Rivercraft911/rava-heart/mechanical/led_power_autoroute_report.csv

led_reference | cap_reference | rotation_deg | status | led_5v_via_x_mm | led_5v_via_y_mm | led_gnd_via_x_mm | led_gnd_via_y_mm | cap_5v_via_x_mm | cap_5v_via_y_mm | cap_gnd_via_x_mm | cap_gnd_via_y_mm | inserted_segments | inserted_vias
D2 | C11 | 0 | partial_manual:cap_5v+cap_gnd+led_5v | 132.3000 | 104.6100 | 133.7000 | 106.3900 | 131.8500 | 103.5000 | 134.1500 | 103.5000 | 1 | 1
D3 | C12 | 0 | partial_manual:cap_5v+cap_gnd | 137.9000 | 104.6100 | 139.3000 | 106.3900 | 137.4500 | 103.5000 | 139.7500 | 103.5000 | 2 | 2
D4 | C13 | 0 | partial_manual:cap_gnd+led_5v+led_gnd | 143.5000 | 104.6100 | 144.9000 | 106.3900 | 143.0500 | 103.5000 | 145.3500 | 103.5000 | 1 | 1
D5 | C14 | 180 | partial_manual:led_gnd | 144.9000 | 111.5900 | 143.5000 | 109.8100 | 145.3500 | 112.7000 | 143.0500 | 112.7000 | 3 | 3
D6 | C15 | 180 | skipped_custom_geometry |  |  |  |  |  |  |  |  | 0 | 0
D7 | C16 | 180 | partial_manual:cap_5v+led_5v+led_gnd | 133.7000 | 111.5900 | 132.3000 | 109.8100 | 134.1500 | 112.7000 | 131.8500 | 112.7000 | 1 | 1
D8 | C17 | 180 | partial_manual:cap_gnd+led_gnd | 128.1000 | 111.5900 | 126.7000 | 109.8100 | 128.5500 | 112.7000 | 126.2500 | 112.7000 | 2 | 2
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
