Rivercraft911/rava-heart/mechanical/heart_matrix_94mm_placement.csv

chain | chain_step | led_reference | cap_reference | x_mm | y_mm | rotation_deg | cap_x_mm | cap_y_mm | cap_rotation_deg | din_net | dout_net
1 | 1 | D13 | C22 | 138.6000 | 121.1000 | 180 | 138.6000 | 123.1000 | 180 | /LED_ARRAY/DIN | Net-(D12-DIN)
1 | 2 | D12 | C21 | 144.2000 | 121.1000 | 180 | 144.2000 | 123.1000 | 180 | Net-(D12-DIN) | Net-(D11-DIN)
1 | 3 | D11 | C20 | 144.2000 | 115.9000 | 0 | 144.2000 | 113.9000 | 0 | Net-(D11-DIN) | Net-(D10-DIN)
1 | 4 | D10 | C19 | 138.6000 | 115.9000 | 0 | 138.6000 | 113.9000 | 0 | Net-(D10-DIN) | Net-(D10-DOUT)
1 | 5 | D9 | C18 | 133.0000 | 115.9000 | 0 | 133.0000 | 113.9000 | 0 | Net-(D10-DOUT) | Net-(D8-DIN)
1 | 6 | D8 | C17 | 127.4000 | 110.7000 | 180 | 127.4000 | 112.7000 | 180 | Net-(D8-DIN) | Net-(D7-DIN)
1 | 7 | D7 | C16 | 133.0000 | 110.7000 | 180 | 133.0000 | 112.7000 | 180 | Net-(D7-DIN) | Net-(D6-DIN)
1 | 8 | D6 | C15 | 138.6000 | 110.7000 | 180 | 138.6000 | 112.7000 | 180 | Net-(D6-DIN) | Net-(D5-DIN)
1 | 9 | D5 | C14 | 144.2000 | 110.7000 | 180 | 144.2000 | 112.7000 | 180 | Net-(D5-DIN) | Net-(D4-DIN)
1 | 10 | D4 | C13 | 144.2000 | 105.5000 | 0 | 144.2000 | 103.5000 | 0 | Net-(D4-DIN) | Net-(D3-DIN)
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
