Rivercraft911/rava-heart/silkscreen_art/IMG_2507-silkscreen-cutout-70mm.png

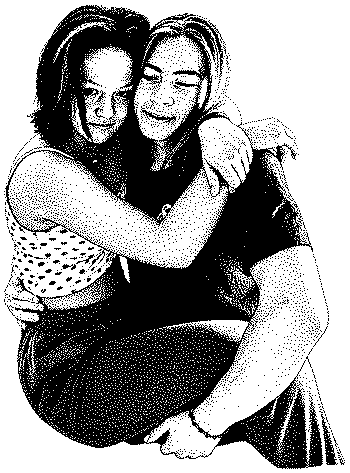
silkscreen_art/IMG_2507-silkscreen-cutout-70mm.png
