Rivercraft911/rava-heart/silkscreen_art/IMG_waterfall-kiss-black-silkscreen-70mm.png

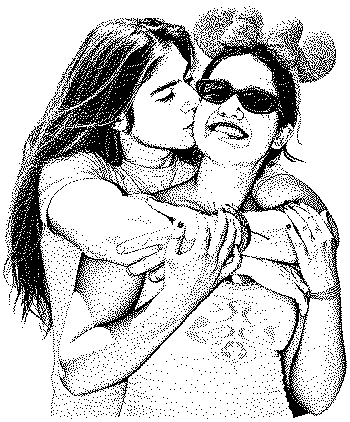
silkscreen_art/IMG_waterfall-kiss-black-silkscreen-70mm.png
