Rivercraft911/rava-heart/hardware/production/MK3TestCost_bom.csv

Designator | Footprint | Quantity | Value | LCSC Part #
C1, C7 | C_0603 | 2 | 1uF | C15849
C10, C100, C101, C102, C103, C104, C105, C106, C107, C108, C109, C11, C110, C111, C112, C113, C114, C115, C116, C117, C118, C119, C12, C120, C121, C122, C123, C124, C125, C126, C127, C128, C129, C13, C130, C131, C132, C133, C134, C135, C136, C137, C138, C139, C14, C140, C141, C142, C143, C144, C145, C146, C147, C148, C149, C15, C150, C151, C152, C153, C154, C155, C156, C157, C158, C159, C16, C160, C161, C162, C163, C164, C17, C18, C19, C2, C20, C21, C22, C28, C3, C32, C33, C34, C35, C36, C37, C38, C39, C40, C41, C42, C43, C44, C45, C46, C47, C48, C49, C5, C50, C51, C52, C53, C54, C55, C56, C57, C58, C59, C6, C60, C61, C62, C63, C64, C65, C66, C67, C68, C69, C70, C71, C72, C73, C74, C75, C76, C77, C78, C79, C8, C80, C81, C82, C83, C84, C85, C86, C87, C88, C89, C9, C90, C91, C92, C93, C94, C95, C96, C97, C98, C99 | C_0402 | 153 | 100nF | C1525
C23 | 0603 | 1 | 6.8nF | C307492
C24, C25, C30, C31 | C_1206 | 4 | 22uF | C12891
C26, C27, C4 | C_1206 | 3 | 10uF | C13585
C29 | C_0402 | 1 | 22pF | C1555
D1 | SOT-23-6_L2.9-W1.6-P0.95-LS2.9-BL | 1 | SRV05-4A_C20615829 | C20615829
D10, D100, D101, D102, D103, D104, D105, D106, D107, D108, D109, D11, D110, D111, D112, D113, D114, D115, D116, D117, D118, D119, D12, D120, D121, D122, D123, D124, D125, D126, D127, D128, D129, D13, D130, D131, D132, D133, D134, D135, D136, D137, D138, D139, D14, D140, D141, D142, D143, D144, D145, D15, D16, D17, D18, D19, D2, D20, D21, D22, D23, D24, D25, D26, D27, D28, D29, D3, D30, D31, D32, D33, D34, D35, D36, D37, D38, D39, D4, D40, D41, D42, D43, D44, D45, D46, D47, D48, D49, D5, D50, D51, D52, D53, D54, D55, D56, D57, D58, D59, D6, D60, D61, D62, D63, D64, D65, D66, D67, D68, D69, D7, D70, D71, D72, D73, D74, D75, D76, D77, D78, D79, D8, D80, D81, D82, D83, D84, D85, D86, D87, D88, D89, D9, D90, D91, D92, D93, D94, D95, D96, D97, D98, D99 | WS2812B-MINI-V6 | 144 | WS2812B-MINI-V6 | C52941386
J1 | TYPE-C-SMD_HX-TYPE-C-16PIN | 1 | Connector, USB-TYPE-C-16P | C2927039
L1 | FTC252010S4R7MBCA | 1 | FTC252010S4R7MBCA | C5832360
R1, R2 | 0603 | 2 | 5.1k | C23186
R10, R11, R14, R15 | R_0402 | 4 | 33Ω | C25105
R12, R13 | R_0402 | 2 | 4.7kΩ | C25900
R16 | R_0402 | 1 | 24kΩ | C25769
R17 | R_0402 | 1 | 680Ω | C25130
R18, R3, R4, R5, R6, R7, R8, R9 | R_0402 | 8 | 10kΩ | C25744
R19 | R_0402 | 1 | 100kΩ | C25741
R20 | R_0402 | 1 | 22kΩ | C25768
R21 | R_0402 | 1 | 200Ω | C25087
S1, S2, S3 | SW_TS-1088-AR02016 | 3 | Tactile Button, 160gf | C720477
TP1 | TestPoint_Pad_1.5x1.5mm | 1 | 5V
TP2, TP3, TP4 | TestPoint_Pad_1.5x1.5mm | 3 | ~
U1 | LGA-12_2x2mm_P0.5mm | 1 | LIS3MDL | C478483
U2 | ESP32-C3-WROOM-02 | 1 | ESP32-C3-WROOM-02 | C2934560
U3 | ST_LGA-14L_2.5x3.0mm_P0.5mm_4x3 | 1 | LSM6DSOX | C481766
U4 | 74AHCT2G125DC_125 | 1 | 74AHCT2G125DC_125 | C554633
U5 | TPS259531DSGR | 1 | TPS259531DSGR | C2155674
U6 | SY8089AAAC | 1 | SY8089AAAC | C78988
