Rivercraft911/rava-heart/mechanical/heart_matrix_94x88_refined_edgecuts.dxf

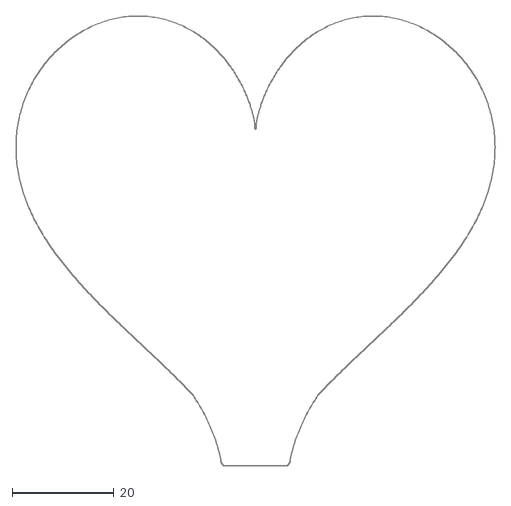
[picture p7: CAD file, 2026-11-10]
mechanical/heart_matrix_94x88_refined_edgecuts.dxf
94.0 x 88.3
