Rivercraft911/rava-heart/hardware/HeartArray.kicad_pcb

## KiCad design hardware/HeartArray.kicad_pcb (2026-11-10)

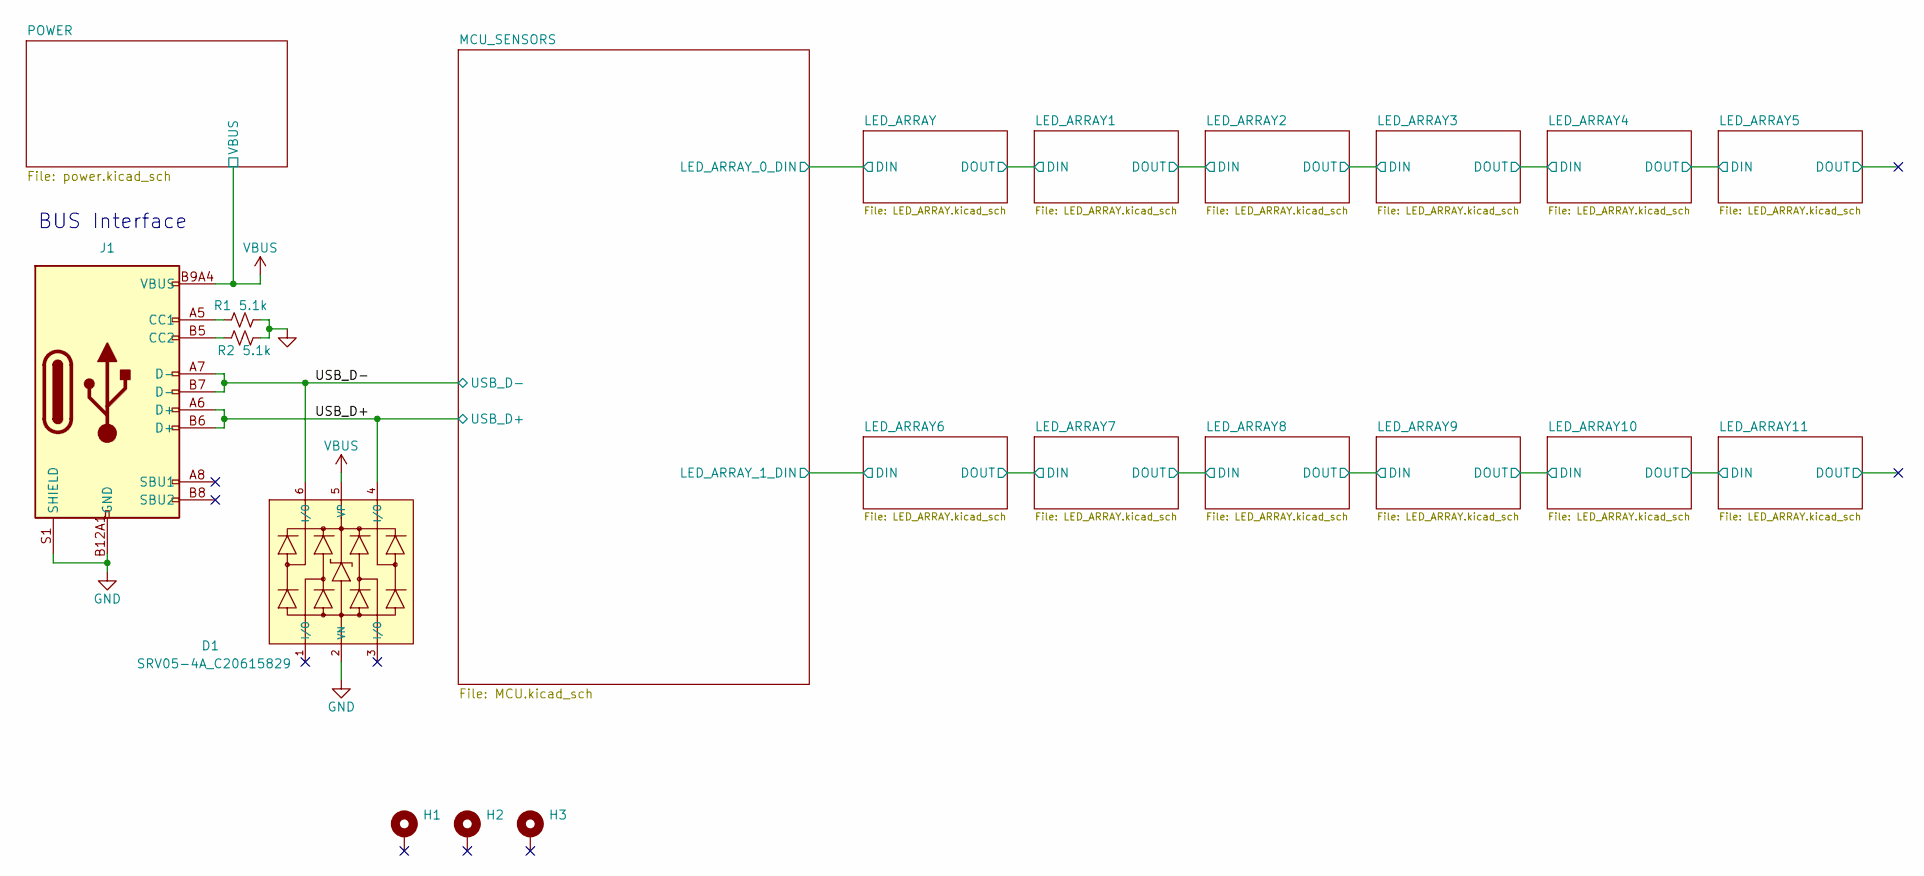
[picture p8: schematic HeartArray.kicad_sch]

Parts:
D1: SRV05-4A_C20615829; SOT-23-6_L2.9-W1.6-P0.95-LS2.9-BL; Part SRV05-4A; LCSC C20615829
H1, H2, H3: MountingHole_Pad; MountingHole_2.2mm_M2_DIN965_Pad
J1: Connector, USB-TYPE-C-16P; TYPE-C-SMD_HX-TYPE-C-16PIN; LCSC C2927039
R1, R2: 5.1k; R_0603_1608Metric; LCSC C23186

Connections:
/USB_D+: D1.4 (I/O), J1.A6 (D+), J1.B6 (D+); also elsewhere on the board
/USB_D-: D1.6 (I/O), J1.A7 (D-), J1.B7 (D-); also elsewhere on the board
GND: D1.2 (VN), J1.A12B1 (GND), J1.B12A1 (GND), J1.S1 (SHIELD), R1.2, R2.2; also elsewhere on the board
unnamed: J1.A5 (CC1), R1.1
unnamed: J1.B5 (CC2), R2.1
VBUS: D1.5 (VP), J1.A9B4 (VBUS), J1.B9A4 (VBUS); also elsewhere on the board

Notes on the sheet:
BUS Interface

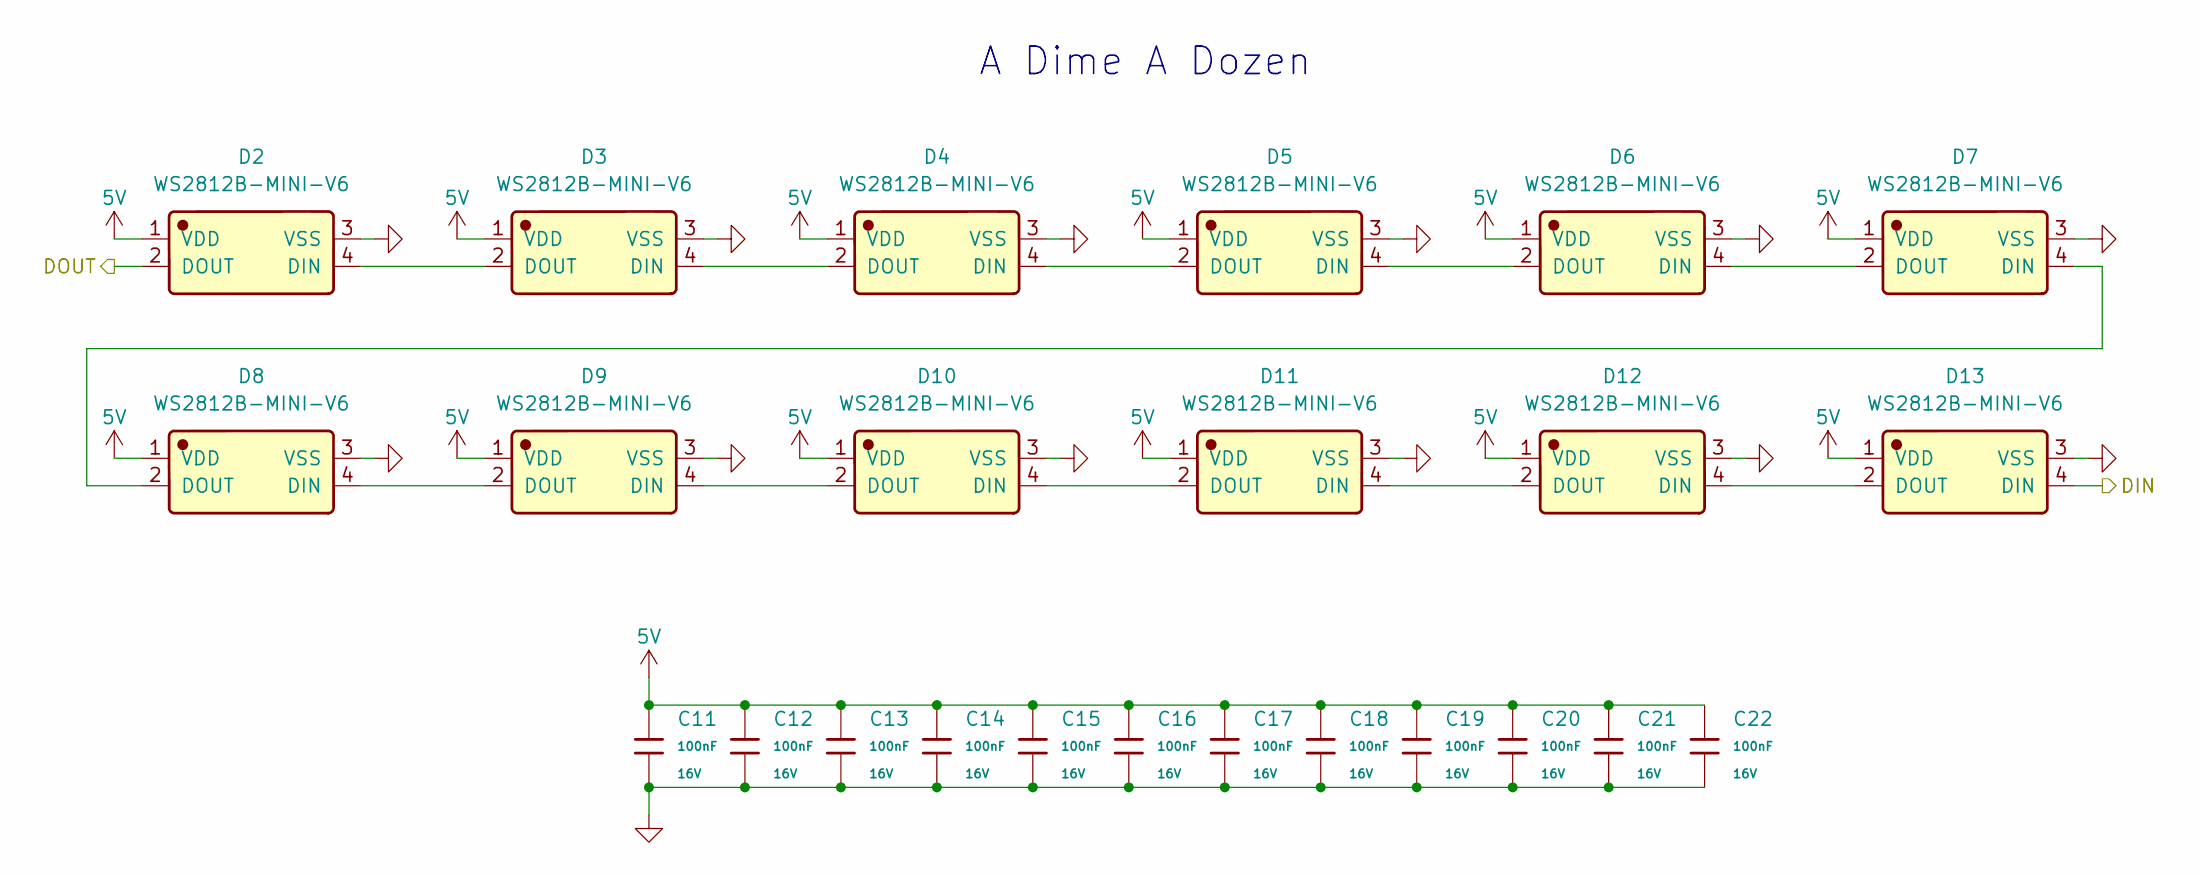
[picture p9: schematic LED_ARRAY.kicad_sch]

Parts:
C11, C12, C13, C14, C15, C16, C17, C18, C19, C20, C21, C22: 100nF; C_0402; Voltage Rated 16V; Tolerance ±10%; Part CL05B104KO5NNNC; LCSC C1525
D2, D3, D4, D5, D6, D7, D8, D9, D10, D11, D12, D13: WS2812B-MINI-V6; Manufacturer Part WS2812B-MINI-V6; LCSC C52941386

Connections:
5V: C11.1, C12.1, C13.1, C14.1, C15.1, C16.1, C17.1, C18.1, C19.1, C20.1, C21.1, C22.1, D2.1 (VDD), D3.1 (VDD), D4.1 (VDD), D5.1 (VDD), D6.1 (VDD), D7.1 (VDD), D8.1 (VDD), D9.1 (VDD), D10.1 (VDD), D11.1 (VDD), D12.1 (VDD), D13.1 (VDD); also elsewhere on the board
/LED_ARRAY/DIN: D13.4 (DIN); also elsewhere on the board
/LED_ARRAY/DOUT: D2.2 (DOUT); also elsewhere on the board
GND: C11.2, C12.2, C13.2, C14.2, C15.2, C16.2, C17.2, C18.2, C19.2, C20.2, C21.2, C22.2, D2.3 (VSS), D3.3 (VSS), D4.3 (VSS), D5.3 (VSS), D6.3 (VSS), D7.3 (VSS), D8.3 (VSS), D9.3 (VSS), D10.3 (VSS), D11.3 (VSS), D12.3 (VSS), D13.3 (VSS); also elsewhere on the board
unnamed: D2.4 (DIN), D3.2 (DOUT)
unnamed: D3.4 (DIN), D4.2 (DOUT)
unnamed: D4.4 (DIN), D5.2 (DOUT)
unnamed: D5.4 (DIN), D6.2 (DOUT)
unnamed: D6.4 (DIN), D7.2 (DOUT)
unnamed: D7.4 (DIN), D8.2 (DOUT)
unnamed: D8.4 (DIN), D9.2 (DOUT)
unnamed: D10.4 (DIN), D11.2 (DOUT)
unnamed: D9.4 (DIN), D10.2 (DOUT)
unnamed: D11.4 (DIN), D12.2 (DOUT)
unnamed: D12.4 (DIN), D13.2 (DOUT)

Parts of its further copies:
C33, C34, C35, C36, C37, C38, C39, C40, C41, C42, C43, C44, C45, C46, C47, C48, C49, C50, C51, C52, C53, C54, C55, C56, C57, C58, C59, C60, C61, C62, C63, C64, C65, C66, C67, C68, C69, C70, C71, C72, C73, C74, C75, C76, C77, C78, C79, C80, C81, C82, C83, C84, C85, C86, C87, C88, C89, C90, C91, C92, C93, C94, C95, C96, C97, C98, C99, C100, C101, C102, C103, C104, C105, C106, C107, C108, C109, C110, C111, C112, C113, C114, C115, C116, C117, C118, C119, C120, C121, C122, C123, C124, C125, C126, C127, C128, C129, C130, C131, C132, C133, C134, C135, C136, C137, C138, C139, C140, C141, C142, C143, C144, C145, C146, C147, C148, C149, C150, C151, C152, C153, C154, C155, C156, C157, C158, C159, C160, C161, C162, C163, C164: 100nF; C_0402; Voltage Rated 16V; Tolerance ±10%; Part CL05B104KO5NNNC; LCSC C1525
D14, D15, D16, D17, D18, D19, D20, D21, D22, D23, D24, D25, D26, D27, D28, D29, D30, D31, D32, D33, D34, D35, D36, D37, D38, D39, D40, D41, D42, D43, D44, D45, D46, D47, D48, D49, D50, D51, D52, D53, D54, D55, D56, D57, D58, D59, D60, D61, D62, D63, D64, D65, D66, D67, D68, D69, D70, D71, D72, D73, D74, D75, D76, D77, D78, D79, D80, D81, D82, D83, D84, D85, D86, D87, D88, D89, D90, D91, D92, D93, D94, D95, D96, D97, D98, D99, D100, D101, D102, D103, D104, D105, D106, D107, D108, D109, D110, D111, D112, D113, D114, D115, D116, D117, D118, D119, D120, D121, D122, D123, D124, D125, D126, D127, D128, D129, D130, D131, D132, D133, D134, D135, D136, D137, D138, D139, D140, D141, D142, D143, D144, D145: WS2812B-MINI-V6; Manufacturer Part WS2812B-MINI-V6; LCSC C52941386

Connections of its further copies:
5V: C33.1, C34.1, C35.1, C36.1, C37.1, C38.1, C39.1, C40.1, C41.1, C42.1, C43.1, C44.1, C45.1, C46.1, C47.1, C48.1, C49.1, C50.1, C51.1, C52.1, C53.1, C54.1, C55.1, C56.1, C57.1, C58.1, C59.1, C60.1, C61.1, C62.1, C63.1, C64.1, C65.1, C66.1, C67.1, C68.1, C69.1, C70.1, C71.1, C72.1, C73.1, C74.1, C75.1, C76.1, C77.1, C78.1, C79.1, C80.1, C81.1, C82.1, C83.1, C84.1, C85.1, C86.1, C87.1, C88.1, C89.1, C90.1, C91.1, C92.1, C93.1, C94.1, C95.1, C96.1, C97.1, C98.1, C99.1, C100.1, C101.1, C102.1, C103.1, C104.1, C105.1, C106.1, C107.1, C108.1, C109.1, C110.1, C111.1, C112.1, C113.1, C114.1, C115.1, C116.1, C117.1, C118.1, C119.1, C120.1, C121.1, C122.1, C123.1, C124.1, C125.1, C126.1, C127.1, C128.1, C129.1, C130.1, C131.1, C132.1, C133.1, C134.1, C135.1, C136.1, C137.1, C138.1, C139.1, C140.1, C141.1, C142.1, C143.1, C144.1, C145.1, C146.1, C147.1, C148.1, C149.1, C150.1, C151.1, C152.1, C153.1, C154.1, C155.1, C156.1, C157.1, C158.1, C159.1, C160.1, C161.1, C162.1, C163.1, C164.1, D14.1 (VDD), D15.1 (VDD), D16.1 (VDD), D17.1 (VDD), D18.1 (VDD), D19.1 (VDD), D20.1 (VDD), D21.1 (VDD), D22.1 (VDD), D23.1 (VDD), D24.1 (VDD), D25.1 (VDD), D26.1 (VDD), D27.1 (VDD), D28.1 (VDD), D29.1 (VDD), D30.1 (VDD), D31.1 (VDD), D32.1 (VDD), D33.1 (VDD), D34.1 (VDD), D35.1 (VDD), D36.1 (VDD), D37.1 (VDD), D38.1 (VDD), D39.1 (VDD), D40.1 (VDD), D41.1 (VDD), D42.1 (VDD), D43.1 (VDD), D44.1 (VDD), D45.1 (VDD), D46.1 (VDD), D47.1 (VDD), D48.1 (VDD), D49.1 (VDD), D50.1 (VDD), D51.1 (VDD), D52.1 (VDD), D53.1 (VDD), D54.1 (VDD), D55.1 (VDD), D56.1 (VDD), D57.1 (VDD), D58.1 (VDD), D59.1 (VDD), D60.1 (VDD), D61.1 (VDD), D62.1 (VDD), D63.1 (VDD), D64.1 (VDD), D65.1 (VDD), D66.1 (VDD), D67.1 (VDD), D68.1 (VDD), D69.1 (VDD), D70.1 (VDD), D71.1 (VDD), D72.1 (VDD), D73.1 (VDD), D74.1 (VDD), D75.1 (VDD), D76.1 (VDD), D77.1 (VDD), D78.1 (VDD), D79.1 (VDD), D80.1 (VDD), D81.1 (VDD), D82.1 (VDD), D83.1 (VDD), D84.1 (VDD), D85.1 (VDD), D86.1 (VDD), D87.1 (VDD), D88.1 (VDD), D89.1 (VDD), D90.1 (VDD), D91.1 (VDD), D92.1 (VDD), D93.1 (VDD), D94.1 (VDD), D95.1 (VDD), D96.1 (VDD), D97.1 (VDD), D98.1 (VDD), D99.1 (VDD), D100.1 (VDD), D101.1 (VDD), D102.1 (VDD), D103.1 (VDD), D104.1 (VDD), D105.1 (VDD), D106.1 (VDD), D107.1 (VDD), D108.1 (VDD), D109.1 (VDD), D110.1 (VDD), D111.1 (VDD), D112.1 (VDD), D113.1 (VDD), D114.1 (VDD), D115.1 (VDD), D116.1 (VDD), D117.1 (VDD), D118.1 (VDD), D119.1 (VDD), D120.1 (VDD), D121.1 (VDD), D122.1 (VDD), D123.1 (VDD), D124.1 (VDD), D125.1 (VDD), D126.1 (VDD), D127.1 (VDD), D128.1 (VDD), D129.1 (VDD), D130.1 (VDD), D131.1 (VDD), D132.1 (VDD), D133.1 (VDD), D134.1 (VDD), D135.1 (VDD), D136.1 (VDD), D137.1 (VDD), D138.1 (VDD), D139.1 (VDD), D140.1 (VDD), D141.1 (VDD), D142.1 (VDD), D143.1 (VDD), D144.1 (VDD), D145.1 (VDD); also elsewhere on the board
/LED_ARRAY1/DOUT: D14.2 (DOUT), D37.4 (DIN)
/LED_ARRAY2/DOUT: D26.2 (DOUT), D49.4 (DIN)
/LED_ARRAY3/DOUT: D38.2 (DOUT), D61.4 (DIN)
/LED_ARRAY4/DOUT: D50.2 (DOUT), D73.4 (DIN)
/LED_ARRAY5/DOUT: D62.2 (DOUT)
/LED_ARRAY6/DIN: D85.4 (DIN); also elsewhere on the board
/LED_ARRAY6/DOUT: D74.2 (DOUT), D97.4 (DIN)
/LED_ARRAY7/DOUT: D86.2 (DOUT), D109.4 (DIN)
/LED_ARRAY8/DOUT: D98.2 (DOUT), D121.4 (DIN)
/LED_ARRAY10/DIN: D110.2 (DOUT), D133.4 (DIN)
/LED_ARRAY10/DOUT: D122.2 (DOUT), D145.4 (DIN)
/LED_ARRAY11/DOUT: D134.2 (DOUT)
/LED_ARRAY/DOUT: D25.4 (DIN); also elsewhere on the board
GND: C33.2, C34.2, C35.2, C36.2, C37.2, C38.2, C39.2, C40.2, C41.2, C42.2, C43.2, C44.2, C45.2, C46.2, C47.2, C48.2, C49.2, C50.2, C51.2, C52.2, C53.2, C54.2, C55.2, C56.2, C57.2, C58.2, C59.2, C60.2, C61.2, C62.2, C63.2, C64.2, C65.2, C66.2, C67.2, C68.2, C69.2, C70.2, C71.2, C72.2, C73.2, C74.2, C75.2, C76.2, C77.2, C78.2, C79.2, C80.2, C81.2, C82.2, C83.2, C84.2, C85.2, C86.2, C87.2, C88.2, C89.2, C90.2, C91.2, C92.2, C93.2, C94.2, C95.2, C96.2, C97.2, C98.2, C99.2, C100.2, C101.2, C102.2, C103.2, C104.2, C105.2, C106.2, C107.2, C108.2, C109.2, C110.2, C111.2, C112.2, C113.2, C114.2, C115.2, C116.2, C117.2, C118.2, C119.2, C120.2, C121.2, C122.2, C123.2, C124.2, C125.2, C126.2, C127.2, C128.2, C129.2, C130.2, C131.2, C132.2, C133.2, C134.2, C135.2, C136.2, C137.2, C138.2, C139.2, C140.2, C141.2, C142.2, C143.2, C144.2, C145.2, C146.2, C147.2, C148.2, C149.2, C150.2, C151.2, C152.2, C153.2, C154.2, C155.2, C156.2, C157.2, C158.2, C159.2, C160.2, C161.2, C162.2, C163.2, C164.2, D14.3 (VSS), D15.3 (VSS), D16.3 (VSS), D17.3 (VSS), D18.3 (VSS), D19.3 (VSS), D20.3 (VSS), D21.3 (VSS), D22.3 (VSS), D23.3 (VSS), D24.3 (VSS), D25.3 (VSS), D26.3 (VSS), D27.3 (VSS), D28.3 (VSS), D29.3 (VSS), D30.3 (VSS), D31.3 (VSS), D32.3 (VSS), D33.3 (VSS), D34.3 (VSS), D35.3 (VSS), D36.3 (VSS), D37.3 (VSS), D38.3 (VSS), D39.3 (VSS), D40.3 (VSS), D41.3 (VSS), D42.3 (VSS), D43.3 (VSS), D44.3 (VSS), D45.3 (VSS), D46.3 (VSS), D47.3 (VSS), D48.3 (VSS), D49.3 (VSS), D50.3 (VSS), D51.3 (VSS), D52.3 (VSS), D53.3 (VSS), D54.3 (VSS), D55.3 (VSS), D56.3 (VSS), D57.3 (VSS), D58.3 (VSS), D59.3 (VSS), D60.3 (VSS), D61.3 (VSS), D62.3 (VSS), D63.3 (VSS), D64.3 (VSS), D65.3 (VSS), D66.3 (VSS), D67.3 (VSS), D68.3 (VSS), D69.3 (VSS), D70.3 (VSS), D71.3 (VSS), D72.3 (VSS), D73.3 (VSS), D74.3 (VSS), D75.3 (VSS), D76.3 (VSS), D77.3 (VSS), D78.3 (VSS), D79.3 (VSS), D80.3 (VSS), D81.3 (VSS), D82.3 (VSS), D83.3 (VSS), D84.3 (VSS), D85.3 (VSS), D86.3 (VSS), D87.3 (VSS), D88.3 (VSS), D89.3 (VSS), D90.3 (VSS), D91.3 (VSS), D92.3 (VSS), D93.3 (VSS), D94.3 (VSS), D95.3 (VSS), D96.3 (VSS), D97.3 (VSS), D98.3 (VSS), D99.3 (VSS), D100.3 (VSS), D101.3 (VSS), D102.3 (VSS), D103.3 (VSS), D104.3 (VSS), D105.3 (VSS), D106.3 (VSS), D107.3 (VSS), D108.3 (VSS), D109.3 (VSS), D110.3 (VSS), D111.3 (VSS), D112.3 (VSS), D113.3 (VSS), D114.3 (VSS), D115.3 (VSS), D116.3 (VSS), D117.3 (VSS), D118.3 (VSS), D119.3 (VSS), D120.3 (VSS), D121.3 (VSS), D122.3 (VSS), D123.3 (VSS), D124.3 (VSS), D125.3 (VSS), D126.3 (VSS), D127.3 (VSS), D128.3 (VSS), D129.3 (VSS), D130.3 (VSS), D131.3 (VSS), D132.3 (VSS), D133.3 (VSS), D134.3 (VSS), D135.3 (VSS), D136.3 (VSS), D137.3 (VSS), D138.3 (VSS), D139.3 (VSS), D140.3 (VSS), D141.3 (VSS), D142.3 (VSS), D143.3 (VSS), D144.3 (VSS), D145.3 (VSS); also elsewhere on the board
unnamed: D14.4 (DIN), D15.2 (DOUT)
unnamed: D15.4 (DIN), D16.2 (DOUT)
unnamed: D16.4 (DIN), D17.2 (DOUT)
unnamed: D17.4 (DIN), D18.2 (DOUT)
unnamed: D18.4 (DIN), D19.2 (DOUT)
unnamed: D19.4 (DIN), D20.2 (DOUT)
unnamed: D20.4 (DIN), D21.2 (DOUT)
unnamed: D21.4 (DIN), D22.2 (DOUT)
unnamed: D22.4 (DIN), D23.2 (DOUT)
unnamed: D23.4 (DIN), D24.2 (DOUT)
unnamed: D24.4 (DIN), D25.2 (DOUT)
unnamed: D26.4 (DIN), D27.2 (DOUT)
unnamed: D27.4 (DIN), D28.2 (DOUT)
unnamed: D28.4 (DIN), D29.2 (DOUT)
unnamed: D29.4 (DIN), D30.2 (DOUT)
unnamed: D30.4 (DIN), D31.2 (DOUT)
unnamed: D31.4 (DIN), D32.2 (DOUT)
unnamed: D32.4 (DIN), D33.2 (DOUT)
unnamed: D33.4 (DIN), D34.2 (DOUT)
unnamed: D34.4 (DIN), D35.2 (DOUT)
unnamed: D35.4 (DIN), D36.2 (DOUT)
unnamed: D36.4 (DIN), D37.2 (DOUT)
unnamed: D38.4 (DIN), D39.2 (DOUT)
unnamed: D39.4 (DIN), D40.2 (DOUT)
unnamed: D40.4 (DIN), D41.2 (DOUT)
unnamed: D41.4 (DIN), D42.2 (DOUT)
unnamed: D42.4 (DIN), D43.2 (DOUT)
unnamed: D43.4 (DIN), D44.2 (DOUT)
unnamed: D44.4 (DIN), D45.2 (DOUT)
unnamed: D45.4 (DIN), D46.2 (DOUT)
unnamed: D46.4 (DIN), D47.2 (DOUT)
unnamed: D47.4 (DIN), D48.2 (DOUT)
unnamed: D48.4 (DIN), D49.2 (DOUT)
unnamed: D50.4 (DIN), D51.2 (DOUT)
unnamed: D51.4 (DIN), D52.2 (DOUT)
unnamed: D52.4 (DIN), D53.2 (DOUT)
unnamed: D53.4 (DIN), D54.2 (DOUT)
unnamed: D54.4 (DIN), D55.2 (DOUT)
unnamed: D55.4 (DIN), D56.2 (DOUT)
unnamed: D56.4 (DIN), D57.2 (DOUT)
unnamed: D57.4 (DIN), D58.2 (DOUT)
unnamed: D58.4 (DIN), D59.2 (DOUT)
unnamed: D59.4 (DIN), D60.2 (DOUT)
unnamed: D60.4 (DIN), D61.2 (DOUT)
unnamed: D62.4 (DIN), D63.2 (DOUT)
unnamed: D63.4 (DIN), D64.2 (DOUT)
unnamed: D64.4 (DIN), D65.2 (DOUT)
unnamed: D65.4 (DIN), D66.2 (DOUT)
unnamed: D66.4 (DIN), D67.2 (DOUT)
unnamed: D67.4 (DIN), D68.2 (DOUT)
unnamed: D68.4 (DIN), D69.2 (DOUT)
unnamed: D69.4 (DIN), D70.2 (DOUT)
unnamed: D70.4 (DIN), D71.2 (DOUT)
unnamed: D71.4 (DIN), D72.2 (DOUT)
unnamed: D72.4 (DIN), D73.2 (DOUT)
unnamed: D74.4 (DIN), D75.2 (DOUT)
unnamed: D75.4 (DIN), D76.2 (DOUT)
unnamed: D76.4 (DIN), D77.2 (DOUT)
unnamed: D77.4 (DIN), D78.2 (DOUT)
unnamed: D78.4 (DIN), D79.2 (DOUT)
unnamed: D79.4 (DIN), D80.2 (DOUT)
unnamed: D80.4 (DIN), D81.2 (DOUT)
unnamed: D81.4 (DIN), D82.2 (DOUT)
unnamed: D82.4 (DIN), D83.2 (DOUT)
unnamed: D83.4 (DIN), D84.2 (DOUT)
unnamed: D84.4 (DIN), D85.2 (DOUT)
unnamed: D86.4 (DIN), D87.2 (DOUT)
unnamed: D87.4 (DIN), D88.2 (DOUT)
unnamed: D88.4 (DIN), D89.2 (DOUT)
unnamed: D89.4 (DIN), D90.2 (DOUT)
unnamed: D90.4 (DIN), D91.2 (DOUT)
unnamed: D91.4 (DIN), D92.2 (DOUT)
unnamed: D92.4 (DIN), D93.2 (DOUT)
unnamed: D93.4 (DIN), D94.2 (DOUT)
unnamed: D94.4 (DIN), D95.2 (DOUT)
unnamed: D95.4 (DIN), D96.2 (DOUT)
unnamed: D96.4 (DIN), D97.2 (DOUT)
unnamed: D98.4 (DIN), D99.2 (DOUT)
unnamed: D100.4 (DIN), D101.2 (DOUT)
unnamed: D99.4 (DIN), D100.2 (DOUT)
unnamed: D101.4 (DIN), D102.2 (DOUT)
unnamed: D102.4 (DIN), D103.2 (DOUT)
unnamed: D103.4 (DIN), D104.2 (DOUT)
unnamed: D104.4 (DIN), D105.2 (DOUT)
unnamed: D105.4 (DIN), D106.2 (DOUT)
unnamed: D106.4 (DIN), D107.2 (DOUT)
unnamed: D107.4 (DIN), D108.2 (DOUT)
unnamed: D108.4 (DIN), D109.2 (DOUT)
unnamed: D110.4 (DIN), D111.2 (DOUT)
unnamed: D111.4 (DIN), D112.2 (DOUT)
unnamed: D112.4 (DIN), D113.2 (DOUT)
unnamed: D113.4 (DIN), D114.2 (DOUT)
unnamed: D114.4 (DIN), D115.2 (DOUT)
unnamed: D115.4 (DIN), D116.2 (DOUT)
unnamed: D116.4 (DIN), D117.2 (DOUT)
unnamed: D117.4 (DIN), D118.2 (DOUT)
unnamed: D118.4 (DIN), D119.2 (DOUT)
unnamed: D119.4 (DIN), D120.2 (DOUT)
unnamed: D120.4 (DIN), D121.2 (DOUT)
unnamed: D122.4 (DIN), D123.2 (DOUT)
unnamed: D123.4 (DIN), D124.2 (DOUT)
unnamed: D124.4 (DIN), D125.2 (DOUT)
unnamed: D125.4 (DIN), D126.2 (DOUT)
unnamed: D126.4 (DIN), D127.2 (DOUT)
unnamed: D127.4 (DIN), D128.2 (DOUT)
unnamed: D128.4 (DIN), D129.2 (DOUT)
unnamed: D129.4 (DIN), D130.2 (DOUT)
unnamed: D130.4 (DIN), D131.2 (DOUT)
unnamed: D131.4 (DIN), D132.2 (DOUT)
unnamed: D132.4 (DIN), D133.2 (DOUT)
unnamed: D134.4 (DIN), D135.2 (DOUT)
unnamed: D135.4 (DIN), D136.2 (DOUT)
unnamed: D136.4 (DIN), D137.2 (DOUT)
unnamed: D137.4 (DIN), D138.2 (DOUT)
unnamed: D138.4 (DIN), D139.2 (DOUT)
unnamed: D139.4 (DIN), D140.2 (DOUT)
unnamed: D140.4 (DIN), D141.2 (DOUT)
unnamed: D141.4 (DIN), D142.2 (DOUT)
unnamed: D142.4 (DIN), D143.2 (DOUT)
unnamed: D143.4 (DIN), D144.2 (DOUT)
unnamed: D144.4 (DIN), D145.2 (DOUT)

Notes on the sheet:
A Dime A Dozen

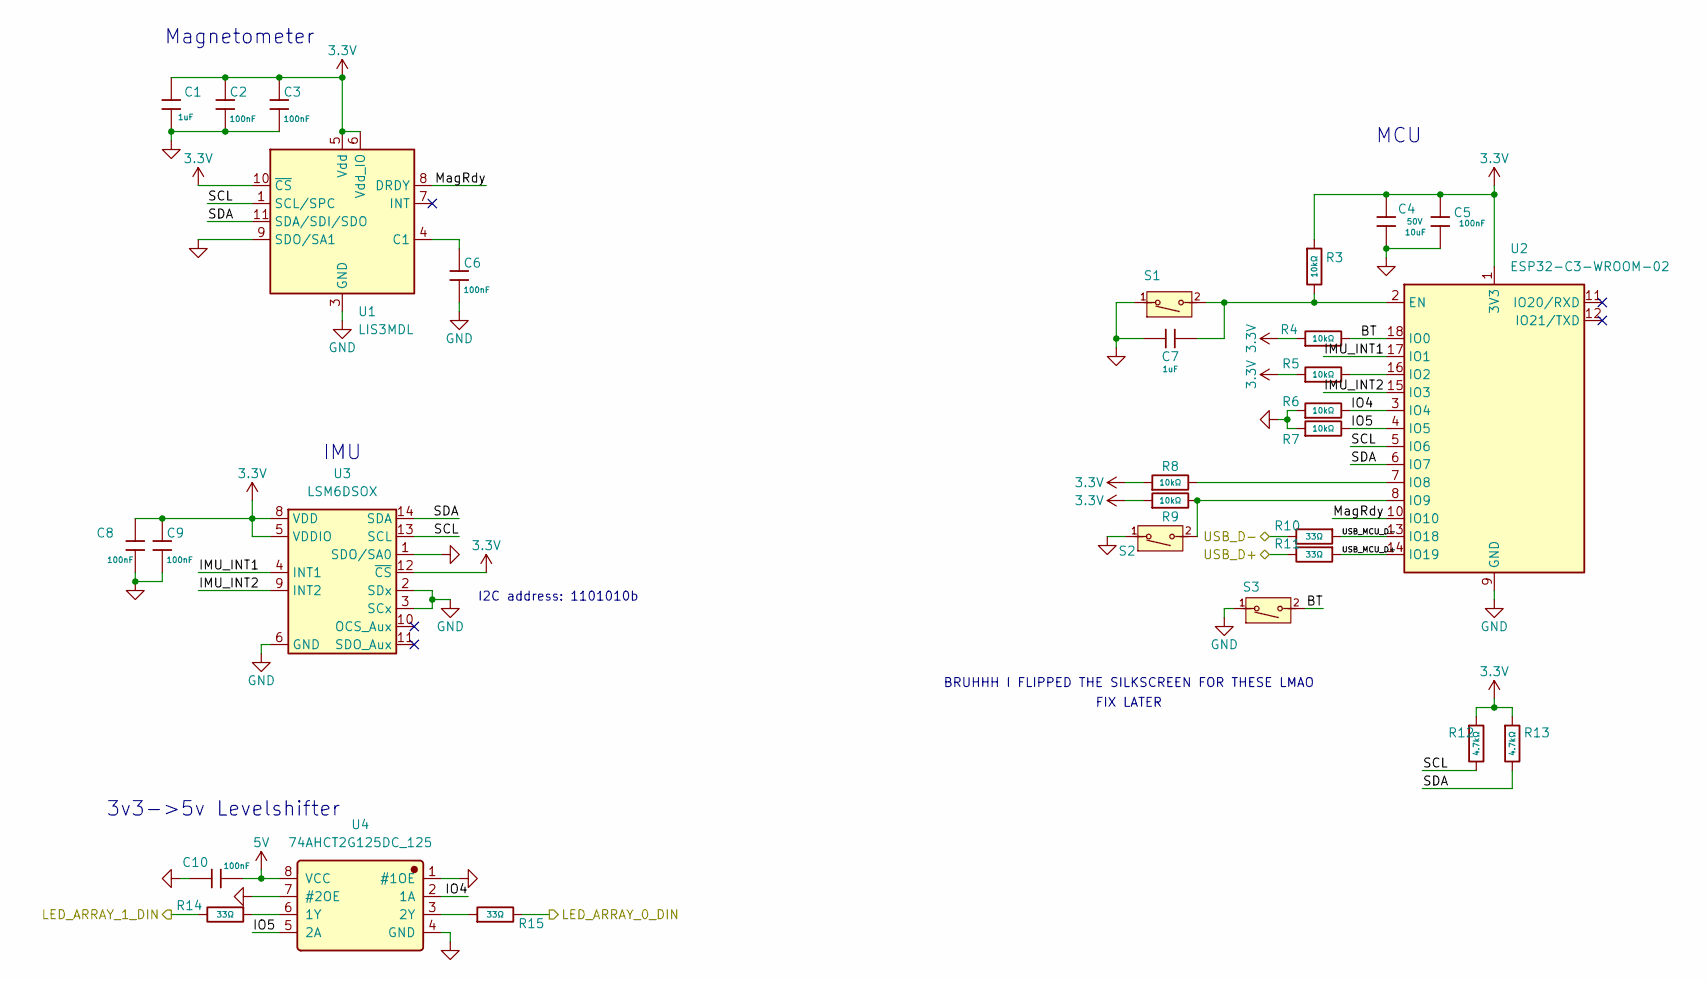
[picture p10: schematic MCU.kicad_sch]

Parts:
C1, C7: 1uF; C_0603; Voltage Rated 50V; Tolerance ±10%; Part CL10A105KB8NNNC; LCSC C15849
C2, C3, C5, C6, C8, C9, C10: 100nF; C_0402; Voltage Rated 16V; Tolerance ±10%; Part CL05B104KO5NNNC; LCSC C1525
C4: 10uF; C_1206; Voltage Rated 50V; Tolerance ±10%; Part CL31A106KBHNNNE; LCSC C13585
R3, R4, R5, R6, R7, R8, R9: 10kΩ; R_0402; Overload Voltage (Max) 50V; Tolerance ±1%; Part 0402WGF1002TCE; LCSC C25744
R10, R11, R14, R15: 33Ω; R_0402; Overload Voltage (Max) 50V; Tolerance ±1%; Part 0402WGF330JTCE; LCSC C25105
R12, R13: 4.7kΩ; R_0402; Overload Voltage (Max) 50V; Tolerance ±1%; Part 0402WGF4701TCE; LCSC C25900
S1, S2, S3: Tactile Button, 160gf; SW_TS-1088-AR02016; Voltage Rating (Dc) 12V; Part TS-1088-AR02016; LCSC C720477
U1: LIS3MDL; LGA-12_2x2mm_P0.5mm; LCSC C478483
U2: ESP32-C3-WROOM-02; LCSC C2934560
U3: LSM6DSOX; ST_LGA-14L_2.5x3.0mm_P0.5mm_4x3; LCSC C481766
U4: 74AHCT2G125DC_125; Manufacturer Part 74AHCT2G125DC,125; LCSC C554633

Connections:
3.3V: C1.1, C2.1, C3.1, C4.1, C5.1, C8.1, C9.1, R3.1, R4.1, R5.1, R8.1, R9.1, R12.1, R13.1, U1.5 (Vdd), U1.6 (Vdd_IO), U1.10 (~CS), U2.1 (3V3), U3.5 (VDDIO), U3.8 (VDD), U3.12 (~CS); also elsewhere on the board
5V: C10.2, U4.8 (VCC); also elsewhere on the board
/LED_ARRAY6/DIN: R14.2; also elsewhere on the board
/LED_ARRAY/DIN: R15.2; also elsewhere on the board
/MCU_SENSORS/BT: R4.2, S3.2 (B), U2.18 (IO0)
/MCU_SENSORS/IMU_INT1: U2.17 (IO1), U3.4 (INT1)
/MCU_SENSORS/IMU_INT2: U2.15 (IO3), U3.9 (INT2)
/MCU_SENSORS/IO4: R6.2, U2.3 (IO4), U4.2 (1A)
/MCU_SENSORS/IO5: R7.2, U2.4 (IO5), U4.5 (2A)
/MCU_SENSORS/MagRdy: U1.8 (DRDY), U2.10 (IO10)
/MCU_SENSORS/SCL: R12.2, U1.1 (SCL/SPC), U2.5 (IO6), U3.13 (SCL)
/MCU_SENSORS/SDA: R13.2, U1.11 (SDA/SDI/SDO), U2.6 (IO7), U3.14 (SDA)
/MCU_SENSORS/USB_MCU_D+: R11.1, U2.14 (IO19)
/MCU_SENSORS/USB_MCU_D-: R10.1, U2.13 (IO18)
/USB_D+: R11.2; also elsewhere on the board
/USB_D-: R10.2; also elsewhere on the board
GND: C1.2, C2.2, C3.2, C4.2, C5.2, C6.2, C7.2, C8.2, C9.2, C10.1, R6.1, R7.1, S1.1 (A), S2.1 (A), S3.1 (A), U1.2 (GND), U1.3 (GND), U1.9 (SDO/SA1), U1.12 (GND), U2.9 (GND), U2.19 (GND), U3.1 (SDO/SA0), U3.2 (SDx), U3.3 (SCx), U3.6 (GND), U3.7 (GND), U4.1 (#1OE), U4.4 (GND), U4.7 (#2OE); also elsewhere on the board
unnamed: C7.1, R3.2, S1.2 (B), U2.2 (EN)
unnamed: R9.2, S2.2 (B), U2.8 (IO9)
unnamed: C6.1, U1.4 (C1)
unnamed: R5.2, U2.16 (IO2)
unnamed: R8.2, U2.7 (IO8)
unnamed: R14.1, U4.6 (1Y)
unnamed: R15.1, U4.3 (2Y)

Notes on the sheet:
IMU
I2C address: 1101010b
BRUHHH I FLIPPED THE SILKSCREEN FOR THESE LMAO
FIX LATER
MCU
Magnetometer
3v3->5v Levelshifter

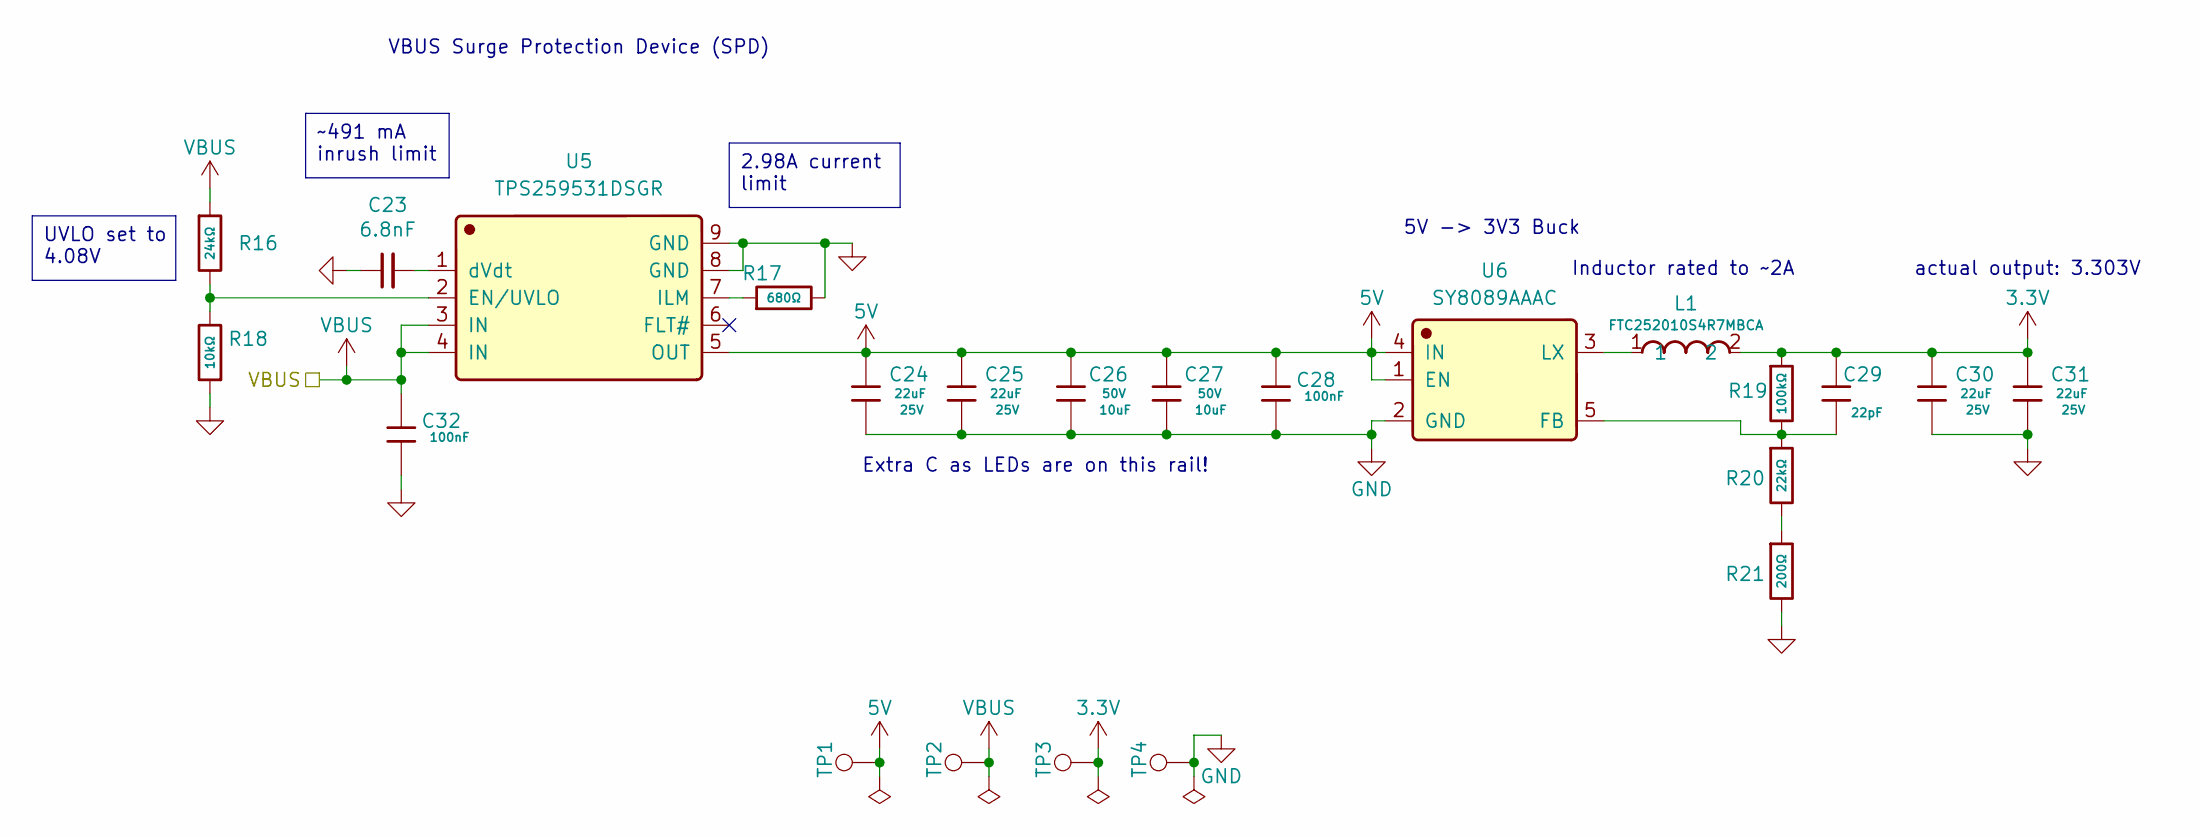
[picture p11: schematic power.kicad_sch]

Parts:
C23: 6.8nF; C_0603_1608Metric; Voltage 50V; Tolerance 5%; LCSC C307492
C24, C25, C30, C31: 22uF; C_1206; Voltage Rated 25V; Tolerance ±10%; Part CL31A226KAHNNNE; LCSC C12891
C26, C27: 10uF; C_1206; Voltage Rated 50V; Tolerance ±10%; Part CL31A106KBHNNNE; LCSC C13585
C28, C32: 100nF; C_0402; Voltage Rated 16V; Tolerance ±10%; Part CL05B104KO5NNNC; LCSC C1525
C29: 22pF; C_0402; Voltage Rated 50V; Tolerance ±5%; Part 0402CG220J500NT; LCSC C1555
L1: FTC252010S4R7MBCA; Manufacturer Part FTC252010S4R7MBCA; LCSC C5832360
R16: 24kΩ; R_0402; Overload Voltage (Max) 50V; Tolerance ±1%; Part 0402WGF2402TCE; LCSC C25769
R17: 680Ω; R_0402; Overload Voltage (Max) 50V; Tolerance ±1%; Part 0402WGF6800TCE; LCSC C25130
R18: 10kΩ; R_0402; Overload Voltage (Max) 50V; Tolerance ±1%; Part 0402WGF1002TCE; LCSC C25744
R19: 100kΩ; R_0402; Overload Voltage (Max) 50V; Tolerance ±1%; Part 0402WGF1003TCE; LCSC C25741
R20: 22kΩ; R_0402; Overload Voltage (Max) 50V; Tolerance ±1%; Part 0402WGF2202TCE; LCSC C25768
R21: 200Ω; R_0402; Overload Voltage (Max) 50V; Tolerance ±1%; Part 0402WGF2000TCE; LCSC C25087
TP1: 5V; TestPoint_Pad_1.5x1.5mm
TP2, TP3, TP4: TestPoint_Pad_1.5x1.5mm
U5: TPS259531DSGR; Manufacturer Part TPS259531DSGR; LCSC C2155674
U6: SY8089AAAC; Manufacturer Part SY8089AAAC; LCSC C78988

Connections:
3.3V: C29.1, C30.1, C31.1, L1.2, R19.1, TP3.1 (1_1); also elsewhere on the board
5V: C24.1, C25.1, C26.1, C27.1, C28.1, TP1.1 (1_1), U5.5 (OUT), U6.1 (EN), U6.4 (IN); also elsewhere on the board
GND: C23.1, C24.2, C25.2, C26.2, C27.2, C28.2, C30.2, C31.2, C32.2, R17.2, R18.1, R21.2, TP4.1 (1_1), U5.8 (GND), U5.9 (GND), U6.2 (GND); also elsewhere on the board
unnamed: R20.2, R21.1
unnamed: R16.2, R18.2, U5.2 (EN/UVLO)
unnamed: R17.1, U5.7 (ILM)
unnamed: C23.2, U5.1 (dVdt)
unnamed: C29.2, R19.2, R20.1, U6.5 (FB)
unnamed: L1.1, U6.3 (LX)
VBUS: C32.1, R16.1, TP2.1 (1_1), U5.3 (IN), U5.4 (IN); also elsewhere on the board

Notes on the sheet:
Extra C as LEDs are on this rail!
5V -> 3V3 Buck
actual output: 3.303V
VBUS Surge Protection Device (SPD)
Inductor rated to ~2A
~491 mA inrush limit
UVLO set to 4.08V
2.98A current limit

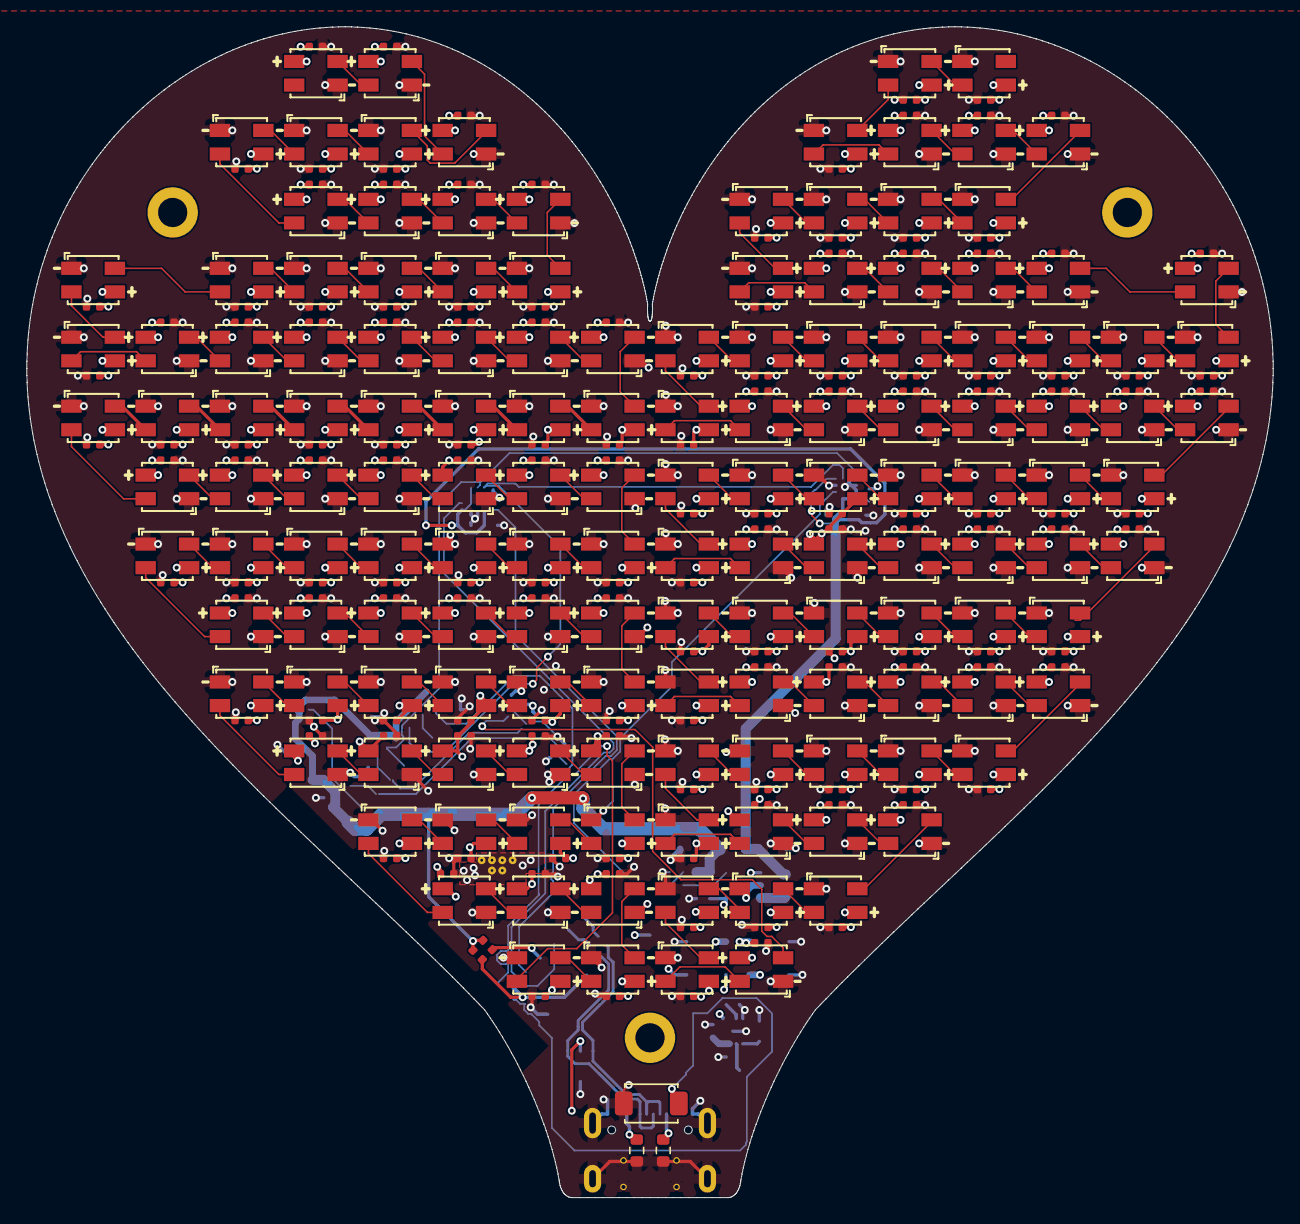
[picture p12: board HeartArray.kicad_pcb from above]

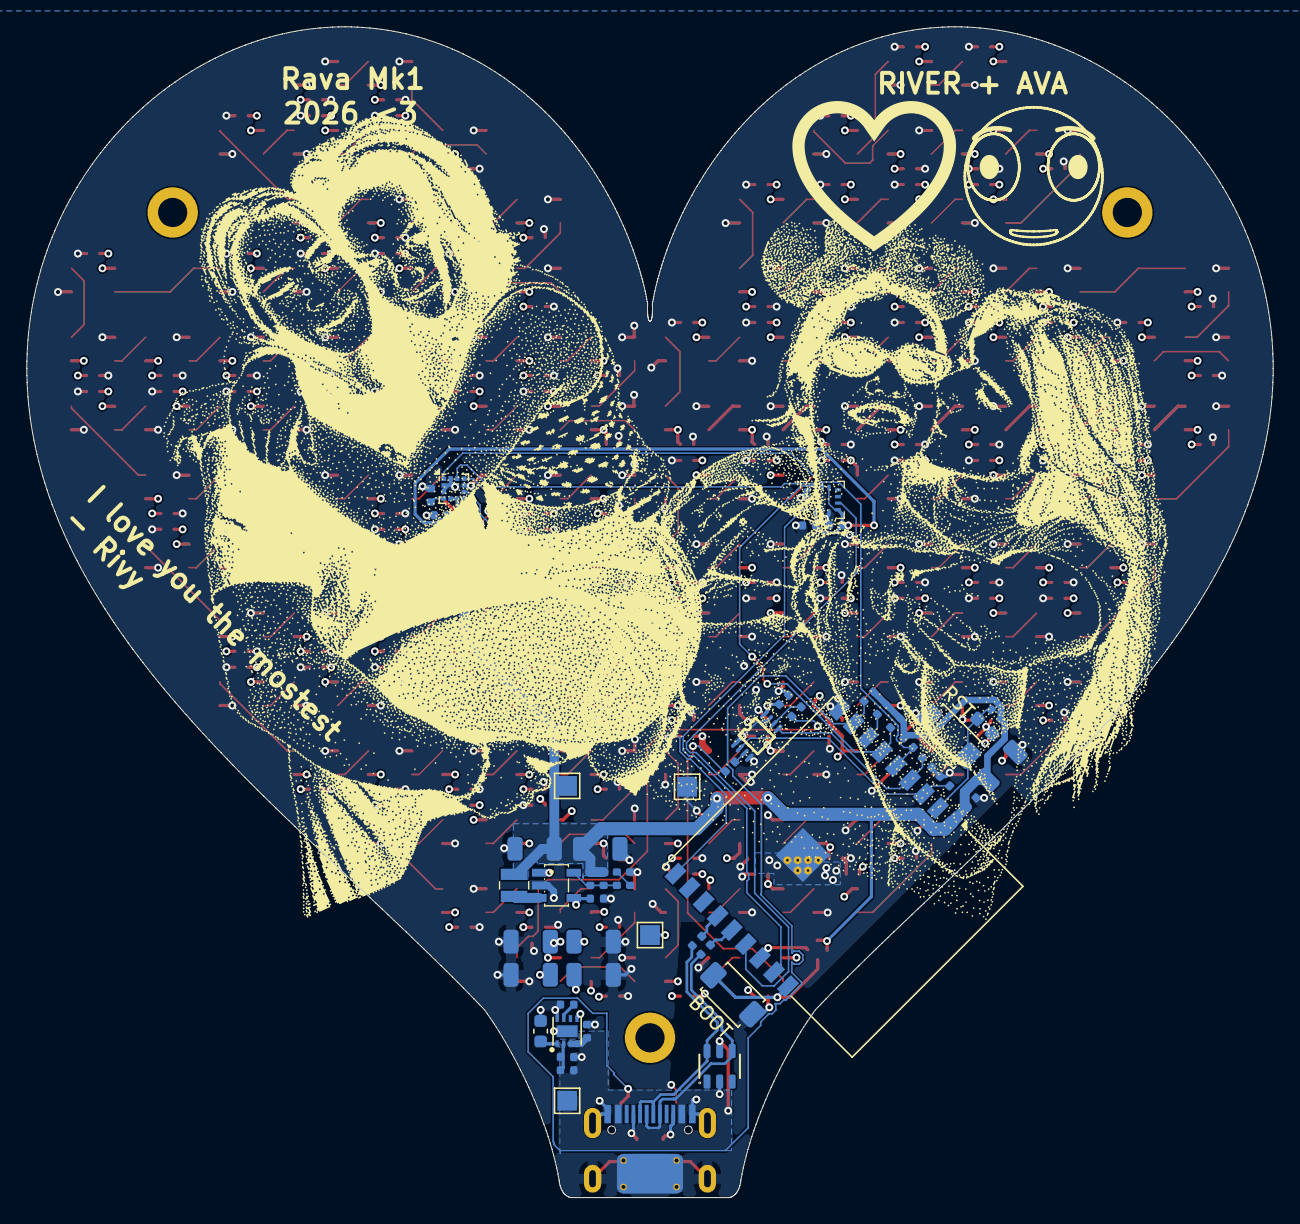
[picture p13: board HeartArray.kicad_pcb from below]

Board: 4 copper layers, 94.0 x 88.3 mm, 348 parts (52 on the bottom side), 175 nets.
